uvmaero/Main-Board-2026/Big Daddy-2025-04-11_172858/Big Daddy-2025-04-11_172858/Big Daddy.kicad_pcb

## KiCad design Big Daddy-2025-04-11_172858/Big Daddy-2025-04-11_172858/Big Daddy.kicad_pcb (2026-03-26)

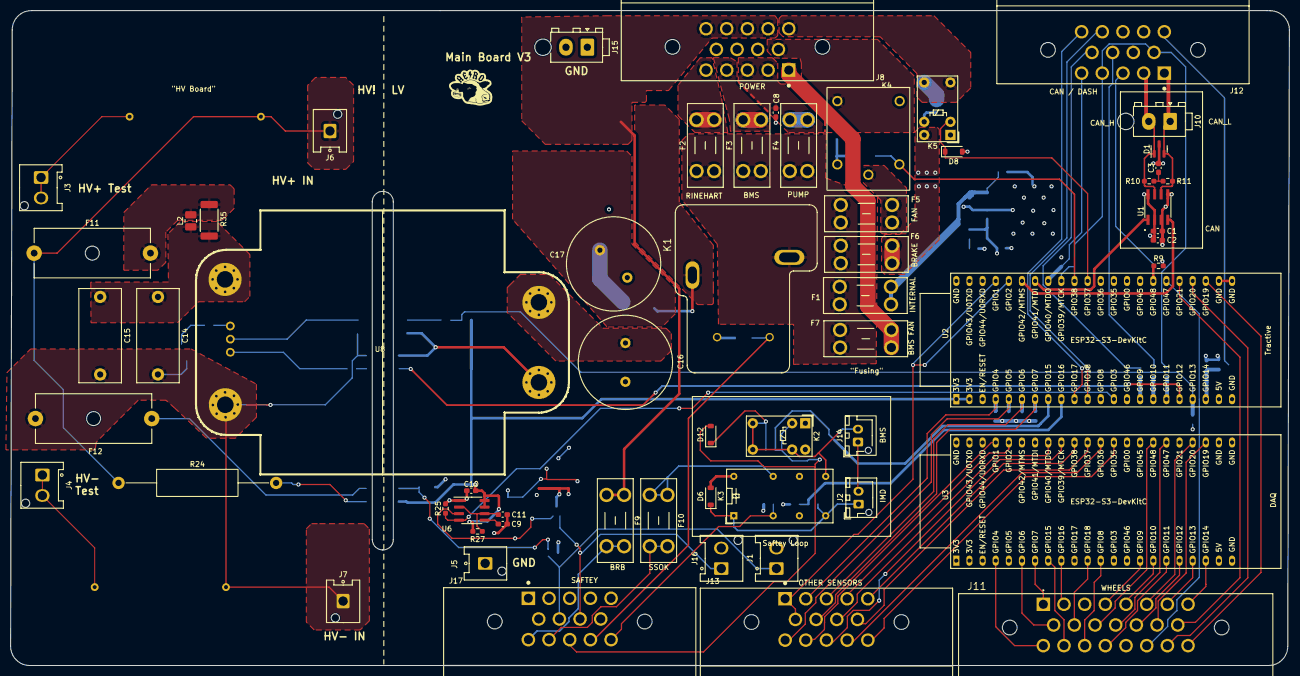
[picture p1: board Big Daddy.kicad_pcb from above]

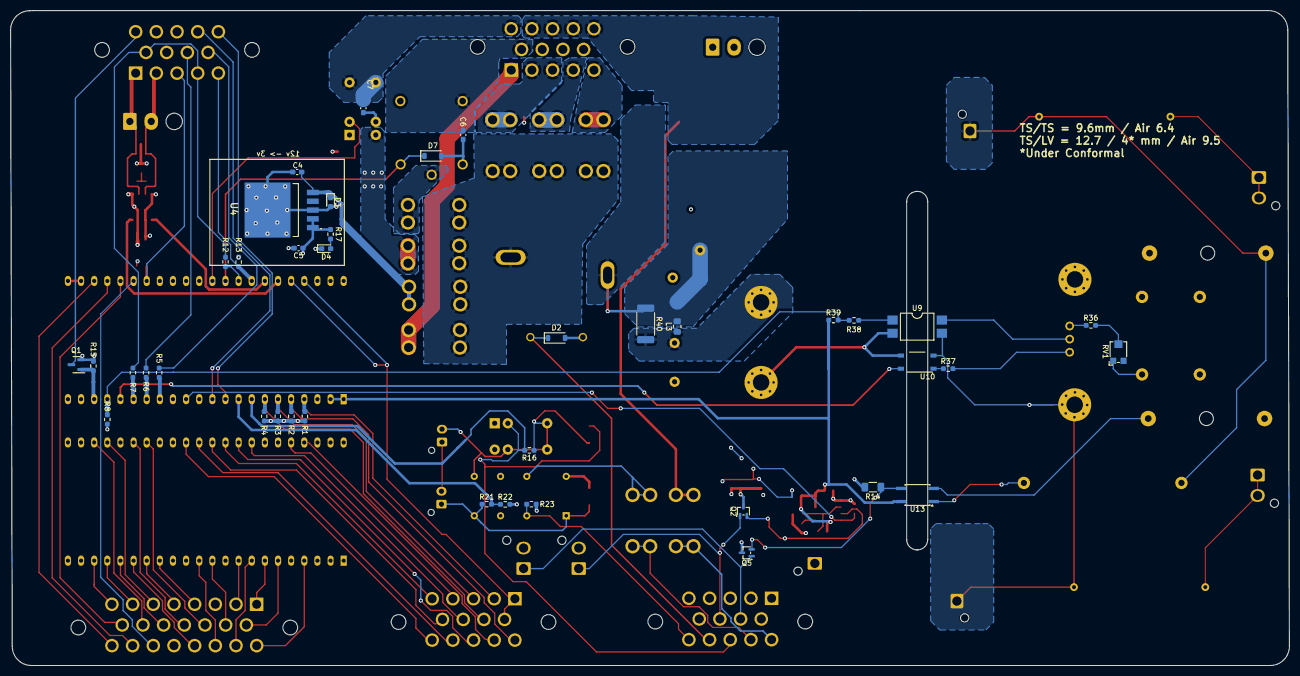
[picture p2: board Big Daddy.kicad_pcb from below]

Board: 4 copper layers, 247.4 x 126.7 mm, 101 parts (39 on the bottom side), 102 nets.

Parts:
C1, C2, C3, C9, C10: .1uF; C_0603_1608Metric_Pad1.08x0.95mm_HandSolder
C4, C6, C7, C8, C11: 10uF; C_0603_1608Metric_Pad1.08x0.95mm_HandSolder
C5: 22uF; C_0603_1608Metric_Pad1.08x0.95mm_HandSolder
C14, C15: 0.68uF; C_Rect_L18.0mm_W8.0mm_P15.00mm_FKS3_FKP3
C16, C17: 4700uF; C_Radial_D18.0mm_H35.5mm_P7.50mm
D1: DESD2CAN2SOQ-7; SOT-23
D2, D6, D7, D8, D12: 1N4148W; D_SOD-123
D3: TS4148C RZG; D_0603_1608Metric_Pad1.05x0.95mm_HandSolder
D4: LED; LED_0603_1608Metric_Pad1.05x0.95mm_HandSolder
F1, F4, F6, F7: 2A; Fuseholder_Blade_Mini_Keystone_3568
F2: 10A; Fuseholder_Blade_Mini_Keystone_3568
F3, F5: 5A; Fuseholder_Blade_Mini_Keystone_3568
F9, F10: 1A; Fuseholder_Blade_Mini_Keystone_3568
F11: 5A; Fuseholder_Cylinder-5x20mm_Schurter_0031_8201_Horizontal_Op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
F12: 1A; Fuseholder_Cylinder-5x20mm_Schurter_0031_8201_Horizontal_Op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
J1: TSSI_Grn I/O; Hirose_DF63R-2P-3.96DSA_1x02_P3.96mm_Vertical
J2: IMD Button; JST_XH_B2B-XH-AM_1x02_P2.50mm_Vertical
J3: HV+; Hirose_DF63R-2P-3.96DSA_1x02_P3.96mm_Vertical
J4: HV-; Hirose_DF63R-2P-3.96DSA_1x02_P3.96mm_Vertical
J5: GND; Hirose_DF63M-1P-3.96DSA_1x01_P3.96mm_Vertical
J6: HV+; Hirose_DF63M-1P-3.96DSA_1x01_P3.96mm_Vertical
J7: HV-; Hirose_DF63M-1P-3.96DSA_1x01_P3.96mm_Vertical
J8, J12, J13, J17: Conn_01x14; TE_1-776266-1_14pin_Horizontal
J10, J15: Conn_01x02; TE_MATE-N-LOK_1-770866-x_1x02_P4.14mm_Vertical
J11: Conn_01x23; TE_1-770669-1_23pin_Horizontal
J14: BMS Button; JST_XH_B2B-XH-AM_1x02_P2.50mm_Vertical
J16: TSSI_Red I/O; Hirose_DF63R-2P-3.96DSA_1x02_P3.96mm_Vertical
K1: T9VV1K15-12S; RELAY_T9VV1K15-12S
K2, K5: G5V-1; Relay_SPDT_Omron_G5V-1
K3: G5V-2; Relay_DPDT_Omron_G5V-2
K4: J107; J1071AS3VDC
L2: 1uH; L_1008_2520Metric_Pad1.43x2.20mm_HandSolder
L3: 0.15uH; L_0805_2012Metric_Pad1.15x1.40mm_HandSolder
Q1: 2N7002; SOT-23
Q2, Q5: RU1C002UN; SOT-323_SC-70
R1, R2, R3, R4, R8, R9, R13, R15, R23, R25: 10k; R_0603_1608Metric_Pad0.98x0.95mm_HandSolder
R5, R6, R7, R12, R17: 330; R_0603_1608Metric_Pad0.98x0.95mm_HandSolder
R10, R11: 60; R_0603_1608Metric_Pad0.98x0.95mm_HandSolder
R14: 2200; R_1206_3216Metric_Pad1.30x1.75mm_HandSolder
R16, R22: 2.2k; R_0603_1608Metric_Pad0.98x0.95mm_HandSolder
R21: 5.97k; R_0603_1608Metric_Pad0.98x0.95mm_HandSolder
R24: 300k; R_Axial_DIN0516_L15.5mm_D5.0mm_P30.48mm_Horizontal
R27: 24k; R_0603_1608Metric_Pad0.98x0.95mm_HandSolder
R32, R33: 20k; R_Axial_DIN0309_L9.0mm_D3.2mm_P5.08mm_Vertical
R35, R40: 1; R_2512_6332Metric_Pad1.40x3.35mm_HandSolder
R36: 300; R_0603_1608Metric_Pad0.98x0.95mm_HandSolder
R37, R38, R39: 1k; R_0603_1608Metric_Pad0.98x0.95mm_HandSolder
RV1: 50k TC33x-2-503E; Potentiometer_Bourns_TC33X_Vertical
U1: MAX33054EASA+T; SOIC127P600X175-8N
U2, U3: ESP32-S3-DevKitC
U4: LT1528CQ#PBF; LT1528CQPBF
U6: ICM7555xB; SOIC-8_3.9x4.9mm_P1.27mm
U8: Vicor_AERO; vicor-socket-no-cutouts
U9: LTV-817S; SMDIP-4_W9.53mm
U10: TLP184; MFSOP6-4_4.4x3.6mm_P1.27mm
U13: LTV-352T; SO-4_4.4x3.6mm_P2.54mm

Connections:
/Connectors/BL_SPEED: J11.23, U2.25 (GPIO19/USB_D-)
/Connectors/BL_STRAIN0: J13.11, U3.41 (GPIO1/ADC1_CH0)
/Connectors/BL_STRAIN1: J13.4, U3.40 (GPIO2/ADC1_CH1)
/Connectors/BL_SUS: J11.7, U3.19 (GPIO13/ADC2_CH2)
/Connectors/BL_TEMP: J11.8, U3.20 (GPIO14/ADC2_CH3)
/Connectors/BMS_12V: F3.2, J8.4
/Connectors/BMS_FAN_PWR_OUT: F7.2, J8.1
/Connectors/BMS_FAULT_SIG: D12.2 (A), J17.12, K2.2, R16.2, U2.8 (GPIO15/ADC2_CH4/32K_P)
/Connectors/BMS_Fault_ind: J12.8, R6.1
/Connectors/BRAKE_PWR_OUT: C7.1, J8.10, K5.5, K5.6
/Connectors/BRB_LOOP: F9.2, J17.10
/Connectors/BRB_RTN: D2.1 (K), J17.13, K1.1
/Connectors/BR_SPEED: J11.22, U2.26 (GPIO20/USB_D+)
/Connectors/BR_STRAIN0: J11.19, U3.17 (GPIO11/ADC2_CH0)
/Connectors/BR_STRAIN1: J11.13, U3.18 (GPIO12/ADC2_CH1)
/Connectors/BR_SUS: J11.4, U3.15 (GPIO9/ADC1_CH8)
/Connectors/BR_TEMP: J11.5, U3.16 (GPIO10/ADC1_CH9)
/Connectors/Batt_12_IN: F9.1, J8.11, J8.12, J8.13, J8.14
/Connectors/Brake_Regen: J12.13, U2.11 (GPIO18/ADC2_CH7)
/Connectors/CAN_H: D1.1 (K), J10.2, J12.2, R10.1, U1.7 (CANH)
/Connectors/CAN_L: D1.2 (K), J10.1, J12.1, R11.2, U1.6 (CANL)
/Connectors/Coast_Regen: J12.14, U2.10 (GPIO17/ADC2_CH6)
/Connectors/DRIVE_MODE_BTTN: J12.5, R13.1, U2.37 (GPIO40/MTDO)
/Connectors/DRIVE_MODE_LED: J12.4, J12.6, R7.1, R12.2
/Connectors/FAN_PWR_OUT: C6.1, J8.6, K4.1
/Connectors/FBrake: J13.3, R3.1, U2.6 (GPIO6/ADC1_CH5)
/Connectors/FL_SPEED: J11.15, U2.27 (GPIO21)
/Connectors/FL_STRAIN0: J11.10, U3.11 (GPIO18/ADC2_CH7)
/Connectors/FL_STRAIN1: J11.18, U3.12 (GPIO8/ADC1_CH7)
/Connectors/FL_SUS: J11.17, U3.8 (GPIO15/ADC2_CH4/32K_P)
/Connectors/FL_TEMP: J11.2, U3.9 (GPIO16/ADC2_CH5/32K_N)
/Connectors/FR_SPEED: J11.21, U2.28 (GPIO47)
/Connectors/FR_STRAIN0: J11.9, U3.6 (GPIO6/ADC1_CH5)
/Connectors/FR_STRAIN1: J11.1, U3.7 (GPIO7/ADC1_CH6)
/Connectors/FR_SUS: J11.16, U3.4 (GPIO4/ADC1_CH3)
/Connectors/FR_TEMP: J11.14, U3.25 (GPIO19/USB_D-)
/Connectors/GPS_RX: J13.12, U3.36 (GPIO39/MTCK)
/Connectors/GPS_TX: J13.8, U3.37 (GPIO40/MTDO)
/Connectors/IMD_FAULT_SIG: J17.14, K3.4, R23.1
/Connectors/IMD_Fault_ind: J12.9, R5.1
/Connectors/IMU_RX: J13.9, U3.34 (GPIO37)
/Connectors/IMU_TX: J13.5, U3.35 (GPIO38)
/Connectors/LoRa_RX: J13.14, U3.32 (GPIO35)
/Connectors/LoRa_TX: J13.13, U3.33 (GPIO36)
/Connectors/PUMP_12V: C8.1, F4.2, J8.2, J8.3
/Connectors/PUMP_TEMP_IN: J13.1, J13.6, U2.40 (GPIO2/ADC1_CH1), U2.41 (GPIO1/ADC1_CH0)
/Connectors/Pedal_0: J13.2, R1.1, U2.4 (GPIO4/ADC1_CH3)
/Connectors/Pedal_1: J13.10, R2.1, U2.5 (GPIO5/ADC1_CH4)
/Connectors/RBrake: J13.7, R4.1, U2.7 (GPIO7/ADC1_CH6)
/Connectors/RINE_12V: F2.2, J8.5
/Connectors/RPi_RX: J11.12, U3.28 (GPIO47)
/Connectors/RPi_TX: J11.11, U3.29 (GPIO48)
/Connectors/RTD_BUZZER_OUT: J12.10, Q1.3 (D)
/Connectors/START_BTTN: J12.3, R9.1, U2.29 (GPIO48)
/Connectors/STEERING: J11.6, U3.26 (GPIO20/USB_D+)
/Connectors/TSSI_Green_in: J1.1, J17.7, Q5.1 (D)
/Connectors/TSSI_Green_out: C4.1, D3.1 (K), F1.2, J1.2, J2.2, J14.1, J16.2, J17.6, J17.9, K2.10, U4.5 (VIN)
/Connectors/TSSI_Red_in: J16.1, J17.8, Q2.1 (D)
/Connectors/TSV: F10.2, J17.11
/Cooling/BRAKE_12V: F6.2, K5.10
/Cooling/Brake_SIG_Out: D8.1 (K), K5.2, U2.34 (GPIO37)
/Cooling/FAN_12V: F5.2, K4.2
/Cooling/Fan_SIG_Out: D7.1 (K), K4.C1, U2.35 (GPIO38)
/Fusing/LOOP_OUT: F10.1, K3.13
/Fusing/Vicor_In: C17.1, K1.3, L3.2, R40.1
/High Voltage/DCDC/EN_HV: U8.3 (EN), U9.4
/High Voltage/DCDC/FAULT_HV: R37.2, U8.4 (FT)
/High Voltage/DCDC/HV+: F11.2, L2.1, R35.2
/High Voltage/DCDC/HV-: C14.2, C15.2, F12.1, J7.1, R33.2, RV1.1, U8.5 (-IN), U9.3, U10.3
/High Voltage/DCDC/TRIM_HV: R36.1, U8.2 (TR)
/High Voltage/TSAL/555_OUT: Q2.2 (G), U6.3 (Q)
/High Voltage/TSAL/HV+: F11.1, J6.1, R24.1, R32.2
/High Voltage/TSAL/HV-: F12.2, U13.2
/High Voltage/TSAL/pass: C11.1, R27.2, U6.2 (TR), U6.6 (THR)
/High Voltage/TSSI_Fault: R25.1, U2.13 (GPIO3/ADC1_CH2), U6.4 (R)
/High Voltage/Vicor_Enable: R8.1, R38.1, R39.2, U2.19 (GPIO13/ADC2_CH2)
/High Voltage/Vicor_Fault: U2.18 (GPIO12/ADC2_CH1), U10.6
/Latching/BMS_Switch: D12.1 (K), J14.2, K2.5, K2.6, K2.9, K3.9, R16.1
/Latching/IMD_IND: R21.2, R22.1, U2.9 (GPIO16/ADC2_CH5/32K_N)
/Latching/IMD_SWITCH: D6.1 (K), J2.1, K3.1, K3.8, R21.1
/Microcontrolller/CAN_RX: U1.4 (RXD), U2.39 (GPIO42/MTMS)
/Microcontrolller/CAN_TX: U1.1 (TXD), U2.38 (GPIO41/MTDI)
/Microcontrolller/RTD_BUZZER: Q1.1 (G), R15.1, U2.20 (GPIO14/ADC2_CH3)
GND: C1.2, C2.2, C3.2, C4.2, C5.2, C6.2, C7.2, C8.2, C9.2, C10.2, C11.2, C16.2, C17.2, D1.3 (A), D2.2 (A), D3.2 (A), D4.1 (K), D6.2 (A), D7.2 (A), D8.2 (A), J5.1, J8.7, J8.8, J8.9, J11.3, J11.20, J12.7, J12.11, J12.12, J15.1, J15.2, K1.2, K3.16, K4.C2, K5.9, Q1.2 (S), Q2.3 (S), Q5.3 (S), R1.2, R2.2, R3.2, R4.2, R8.2, R9.2, R13.2, R14.2, R15.2, R22.2, R23.2, R25.2, U1.2 (GND), U1.8 (STBY), U2.22 (GND), U2.23 (GND), U2.24 (GND), U2.44 (GND), U3.22 (GND), U3.23 (GND), U3.24 (GND), U3.44 (GND), U4.3 (GND), U6.1 (GND), U8.8 (-OUT), U9.2, U10.4
unnamed: C3.1, R10.2, R11.1
unnamed: D4.2 (A), R17.2
unnamed: F1.1, F2.1, F3.1, F4.1, F5.1, F6.1, F7.1, K1.4
unnamed: J3.1, J3.2, R32.1
unnamed: J4.1, J4.2, R33.1
unnamed: Q5.2 (G), R14.1, U13.3
unnamed: R24.2, U13.1
unnamed: R36.2, RV1.2
unnamed: R37.1, U10.1
unnamed: R38.2, U9.1
unnamed: R5.2, U2.15 (GPIO9/ADC1_CH8)
unnamed: R6.2, U2.16 (GPIO10/ADC1_CH9)
unnamed: R7.2, U2.17 (GPIO11/ADC2_CH0)
unnamed: R12.1, U2.36 (GPIO39/MTCK)
unnamed: C9.1, U6.5 (CV)
unnamed: C14.1, C15.1, L2.2, R35.1, U8.1 (+IN)
unnamed: C16.1, L3.1, R40.2, U8.9 (+OUT)
VDD: C1.1, C2.1, C5.1, C10.1, R17.1, R27.1, R39.1, U1.3 (VDD), U1.5 (VL), U2.1 (3V3), U2.2 (3V3), U3.1 (3V3), U3.2 (3V3), U4.1 (OUTPUT), U4.2 (SENSE), U6.7 (DIS), U6.8 (VCC), U13.4
