uvmaero/Main-Board-2026/(commit log)

2026-03-17 cut out diode arrays
2026-03-25 updated lights
    [TSAL.kicad_sch]
2026-03-25 footprints found for fets and Rs
    [TSAL.kicad_sch]
2026-03-26 Rerouted PCB
    [Big Daddy.kicad_pcb, Big Daddy.kicad_sch, Connectors.kicad_sch, Cooling.kicad_sch, Fusing.kicad_sch, Micro.kicad_sch, TSAL.kicad_sch]
2026-03-26 BOM update
    [Big Daddy.kicad_pcb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]
2026-03-31 Deleted TSV schematic
